Ttl/sam_board/hardware/sam_board.pdf

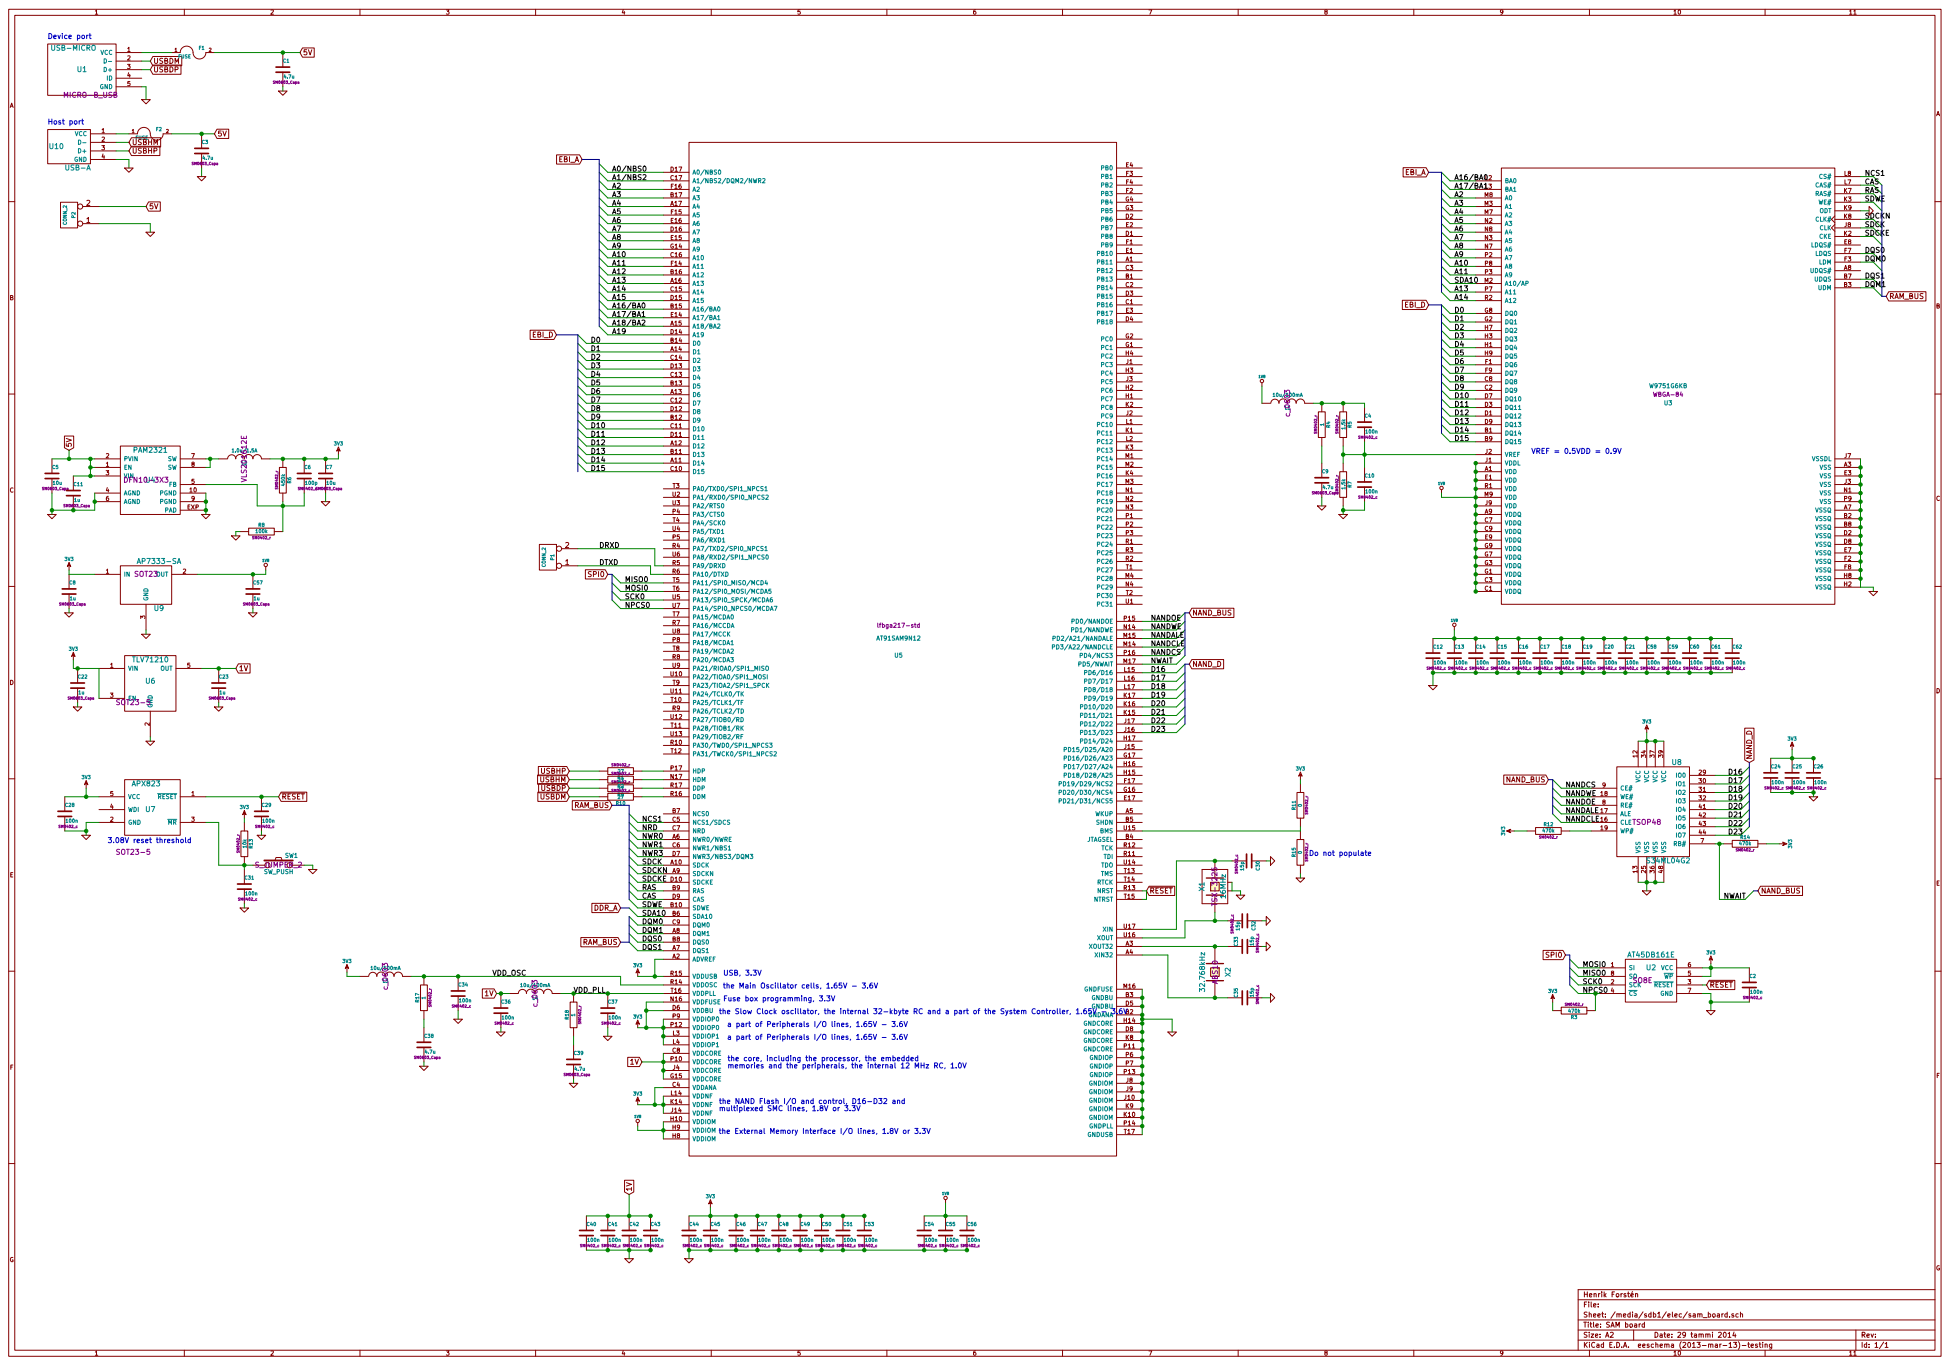
[picture p1: page 1]

USB, 3.3V
the Main Oscillator cells, 1.65V - 3.6V
Fuse box programming, 3.3V
the Slow Clock oscillator, the internal 32-kbyte RC and a part of the System Controller, 1.65V - 3.6V
a part of Peripherals I/O lines, 1.65V - 3.6V

the core, including the processor, the embedded
memories and the peripherals, the internal 12 MHz RC, 1.0V

the NAND Flash I/O and control, D16-D32 and
multiplexed SMC lines, 1.8V or 3.3V

SM0402_c the External Memory Interface I/O lines, 1.8V or 3.3V

Sheet: /media/sdb1/elec/sam_board.sch File: Title: SAM board
