Ttl/sam_board/hardware/sam_board.kicad_pcb

## KiCad design hardware/sam_board.kicad_pcb (2014-07-10)

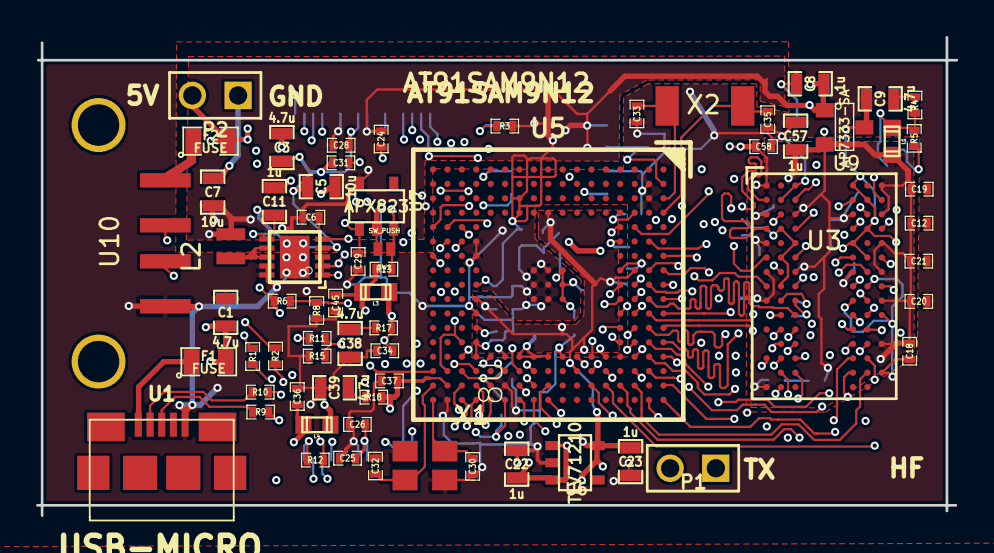
[picture p2: board sam_board.kicad_pcb from above]

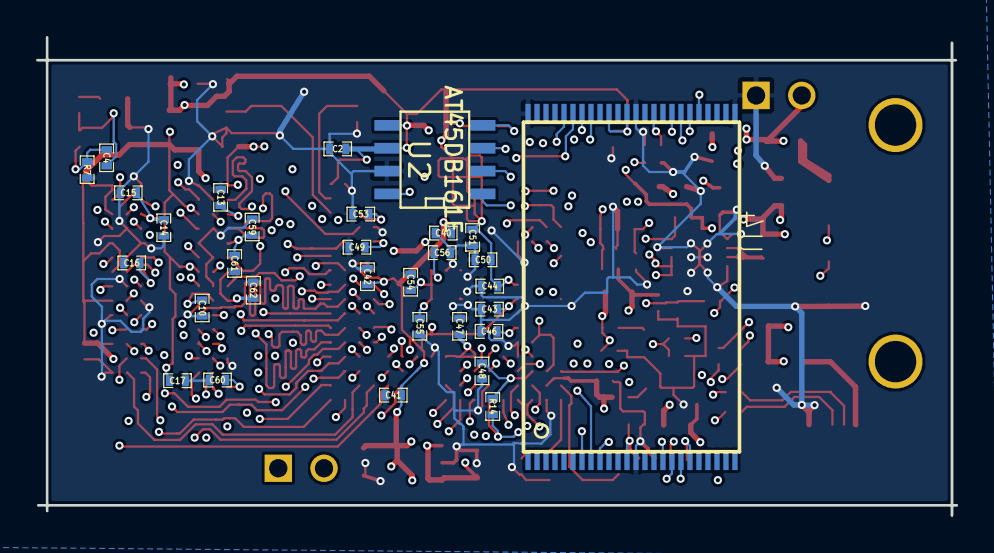
[picture p3: board sam_board.kicad_pcb from below]

Board: 4 copper layers, 51.1 x 26.6 mm, 98 parts (31 on the bottom side), 94 nets.

Parts:
C1, C3, C9, C38, C39: 4.7u; SM0603_Capa
C2, C4, C10, C12, C13, C14, C15, C16, C17, C18, C19, C20, C21, C24, C25, C26, C28, C29, C31, C34, C36, C37, C40, C41, C42, C43, C44, C45, C46, C47, C48, C49, C50, C51, C53, C54, C55, C56, C58, C59, C60, C61, C62: 100n; SM0402_c
C5, C7: 10u; SM0603_Capa
C6: 100p; SM0402_c
C8, C11, C22, C23, C57: 1u; SM0603_Capa
C30, C32, C33, C35: 15p; SM0402_c
F1, F2: FUSE; SM0805
L1, L3, L4: 10u/100mA; c_0603
L2: 1.0u/1.5A; VLS201612E
P1, P2: CONN_2; PIN_ARRAY_2X1
R1, R2, R9, R10: 27; SM0402_r
R3, R12, R14: 470k; SM0402_r
R4, R17, R18: 1; SM0402_r
R5, R7: 1.5k; SM0402_r
R6: 450k; SM0402_r
R8: 100k; SM0402_r
R11, R15: 0; SM0402_r
R13: 10k; SM0402_r
SW1: SW_PUSH; S_JUMPER_2
U1: USB-MICRO; MICRO-B_USB
U2: AT45DB161E; SO8E
U3: W9751G6KB; WBGA-84
U4: PAM2321; DFN10-3X3
U5: AT91SAM9N12; lfbga217-std
U6: TLV71210; SOT23-5
U7: APX823; SOT23-5
U8: S34ML04G2; TSOP48
U9: AP7333-SA; SOT23
U10: USB-A; USB-A-SMD
X1: 16MHz; TSX-3225
X2: 32.768kHz; ABS10

Connections:
1V: C23.1, C36.1, C40.1, C41.1, C42.1, C43.1, L4.1, U5.C8, U5.G15, U5.J4, U5.P10, U6.5
3V3: C2.1, C6.1, C7.1, C8.1, C22.1, C24.1, C25.1, C26.1, C28.1, C44.1, C45.1, C46.1, C47.1, C48.1, C49.1, C50.1, C51.1, C53.1, L2.2, L3.1, R3.2, R6.1, R11.2, R12.1, R13.1, R14.2, U2.5, U2.6, U5.A2, U5.C4, U5.D6, U5.J14, U5.K14, U5.L3, U5.L4, U5.L14, U5.N16, U5.P9, U5.P12, U5.R15, U6.1, U6.3, U7.5, U8.12, U8.34, U8.37, U8.39, U9.1
5V: C1.1, C3.1, C5.1, C11.1, F1.2, F2.2, P2.2, U4.1, U4.2, U4.3
+1.8V: C12.1, C13.1, C14.1, C15.1, C16.1, C17.1, C18.1, C19.1, C20.1, C21.1, C54.1, C55.1, C56.1, C57.1, C58.1, C59.1, C60.1, C61.1, C62.1, L1.1, U3.A1, U3.A9, U3.C1, U3.C3, U3.C7, U3.C9, U3.E1, U3.E9, U3.G1, U3.G3, U3.G7, U3.G9, U3.J1, U3.J9, U3.M9, U3.R1, U5.H8, U5.H9, U5.H10, U9.2
/A2: U3.M8, U5.F16
/A3: U3.M3, U5.B17
/A4: U3.M7, U5.A17
/A5: U3.N2, U5.F15
/A6: U3.N8, U5.E16
/A7: U3.N3, U5.D16
/A8: U3.N7, U5.E15
/A9: U3.P2, U5.G14
/A10: U3.P8, U5.C16
/A11: U3.P3, U5.F14
/A13: U3.P7, U5.A16
/A14: U3.R2, U5.C15
/A16/BA0: U3.L2, U5.B15
/A17/BA1: U3.L3, U5.E14
/CAS: U3.L7, U5.D9
/D0: U3.G8, U5.B14
/D1: U3.G2, U5.A14
/D2: U3.H7, U5.C14
/D3: U3.H3, U5.D13
/D4: U3.H1, U5.C13
/D5: U3.H9, U5.B13
/D6: U3.F1, U5.A13
/D7: U3.F9, U5.C12
/D8: U3.C8, U5.D12
/D9: U3.C2, U5.B12
/D10: U3.D7, U5.C11
/D11: U3.D3, U5.D11
/D12: U3.D1, U5.A12
/D13: U3.D9, U5.B11
/D14: U3.B1, U5.A11
/D15: U3.B9, U5.C10
/D16: U5.L15, U8.29
/D17: U5.L16, U8.30
/D18: U5.L17, U8.31
/D19: U5.K17, U8.32
/D20: U5.K16, U8.41
/D21: U5.K15, U8.42
/D22: U5.J17, U8.43
/D23: U5.J16, U8.44
/DQM0: U3.F3, U5.C9
/DQM1: U3.B3, U5.A8
/DQS0: U3.F7, U5.B8
/DQS1: U3.B7, U5.A7
/DRXD: P1.2, U5.R5
/DTXD: P1.1, U5.R6
/MISO0: U2.8, U5.T5
/MOSI0: U2.1, U5.T6
/NANDALE: U5.M15, U8.17
/NANDCLE: U5.M14, U8.16
/NANDCS: U5.P16, U8.9
/NANDOE: U5.P15, U8.8
/NANDWE: U5.N14, U8.18
/NCS1: U3.L8, U5.C5
/NPCS0: R3.1, U2.4, U5.U7
/NWAIT: R14.1, U5.M17, U8.7
/RAS: U3.K7, U5.B9
/SCK0: U2.2, U5.U5
/SDA10: U3.M2, U5.B6
/SDCK: U3.J8, U5.A10
/SDCKE: U3.K2, U5.D10
/SDCKN: U3.K8, U5.A9
/SDWE: U3.K3, U5.B10
/VDD_OSC: C34.1, L3.2, R17.2, U5.R14
/VDD_PLL: C37.1, L4.2, R18.2, U5.T16
GND: C1.2, C2.2, C3.2, C5.2, C7.2, C8.2, C9.2, C10.2, C11.2, C12.2, C13.2, C14.2, C15.2, C16.2, C17.2, C18.2, C19.2, C20.2, C21.2, C22.2, C23.2, C24.2, C25.2, C26.2, C28.2, C29.2, C30.1, C31.2, C32.1, C33.2, C34.2, C35.2, C36.2, C37.2, C38.2, C39.2, C40.2, C41.2, C42.2, C43.2, C44.2, C45.2, C46.2, C47.2, C48.2, C49.2, C50.2, C51.2, C53.2, C54.2, C55.2, C56.2, C57.2, C58.2, C59.2, C60.2, C61.2, C62.2, P2.1, R7.2, R8.1, R15.1, SW1.2, U1.5, U2.7, U3.A3, U3.A7, U3.B2, U3.B8, U3.D2, U3.D8, U3.E3, U3.E7, U3.F2, U3.F8, U3.H2, U3.H8, U3.J3, U3.J7, U3.K9, U3.N1, U3.P9, U4.4, U4.6, U4.9, U4.10, U4.EXP, U5.B2, U5.B3, U5.D5, U5.D8, U5.H14, U5.J8, U5.J9, U5.J10, U5.K8, U5.K9, U5.K10, U5.M16, U5.P6, U5.P7, U5.P11, U5.P13, U5.P14, U5.T17, U6.2, U7.2, U8.13, U8.25, U8.36, U8.48, U9.3, U10.4, X1.2, X1.4
unnamed: C4.2, C10.1, R5.2, R7.1, U3.J2
unnamed: L2.1, U4.7, U4.8
unnamed: C38.1, R17.1
unnamed: C6.2, R6.2, R8.2, U4.5
unnamed: F2.1, U10.1
unnamed: R2.1, U5.N17
unnamed: R1.1, U5.P17
unnamed: R12.2, U8.19
unnamed: C32.2, U5.U16, X1.1
unnamed: C39.1, R18.1
unnamed: C9.1, R4.2
unnamed: F1.1, U1.1
unnamed: R10.1, U5.R16
unnamed: R9.1, U5.R17
unnamed: R11.1, R15.2, U5.U15
unnamed: C31.1, R13.2, SW1.1, U7.3
unnamed: C30.2, U5.U17, X1.3
unnamed: C4.1, L1.2, R4.1, R5.1
unnamed: C35.1, U5.A4, X2.2
unnamed: C33.1, U5.A3, X2.1
USBDM: R10.2, U1.2
USBDP: R9.2, U1.3
USBHM: R2.2, U10.2
USBHP: R1.2, U10.3
~RESET: C29.1, U2.3, U5.R13, U5.T15, U7.1
