Ttl/sam_board/(threads)

Thread 3 (2015-04-19):

BOM

brianschiffer, 2015-04-19:
Could you post a Bill of Materials? Thanks, this is an awesome project!

Ttl, 2015-04-22:
Added a list of components that I ordered. There are some extra components and it might be missing something, so double check everything if you are planning to order anything from it.

Closed 2015-04-22.

Thread 4 (2017-06-07):

Supervisor reset switch

karpenet, 2017-06-07:
Have you used the manual reset switch for APX823 in the actual board, or just left it open?

Ttl, 2017-06-07:
It's meant to be left open. It's basically just a test point.

Closed 2017-06-07.
